RFLAcademy/SkateGuard/Documentation/Phase 1 - Foundation & Design/README.md

# Phase 1 — Foundation and Design (Week 1)

**Planned:** finalise the prototype layout, lock the wobble threshold, confirm the kickflip approach and procure the hardware.

**Delivered:** the layout and the detection approach were fixed, and the parts list was bought around two XIAO ESP32-C3 boards.

- Board unit mounted under the deck on a plate that bolts around the truck baseplate; wrist unit on a strap.
- Parts: two Seeed XIAO ESP32-C3 boards, a BNO055 IMU, a NEO-8M GPS, an SSD1306 128×32 OLED, two 1500 mAh lithium cells, two USB-C charging modules, a vibration motor and indicator LEDs.
- Kickflip detection scoped to rotation on one gyro axis, with the landing judged by how the deck settles rather than by an impact spike.
- Wobble redefined as a counted oscillation pattern instead of a 25 km/h speed trigger. The reasoning is in the root [README](../../README.md) and the project report.

## CAD design

Both enclosures were designed in CAD before anything was printed, so component clearances, port positions and the mounting pattern were settled on screen rather than in filament. Both are 3D-printed, two-part enclosures holding their board, a 1500 mAh lithium cell and a USB-C charging module, with every port and indicator reachable without opening the case.

### Board unit

The board enclosure is a mounting plate that sits between the deck and the truck, with the hardware split into three compartments so each part gets what it needs: the GPS patch antenna faces up with a clear view of the sky, the IMU sits in its own pod on the plate's edge where it reads the deck's rotation directly, and the XIAO, cell and charging module fill the opposite compartment. The oval and slotted cut-outs drop weight and clear the mounting bolts.

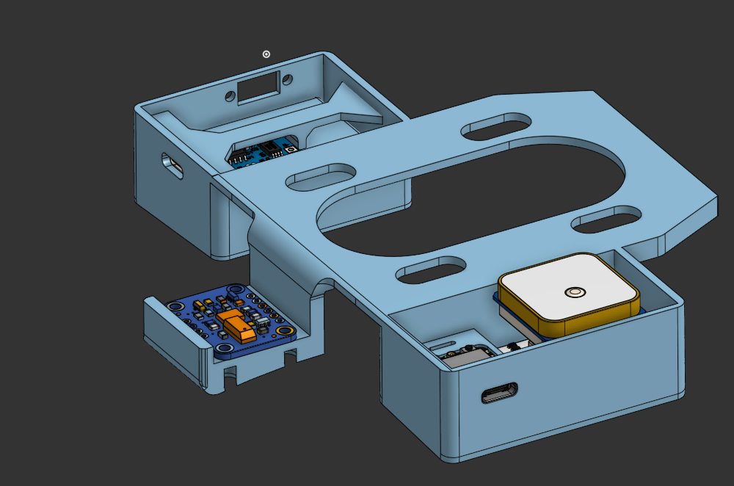
[picture p10: Documentation/Phase 1 - Foundation & Design/images/board_exploded.png]
Board enclosure, base and lid separated, showing the IMU pod and the GPS antenna


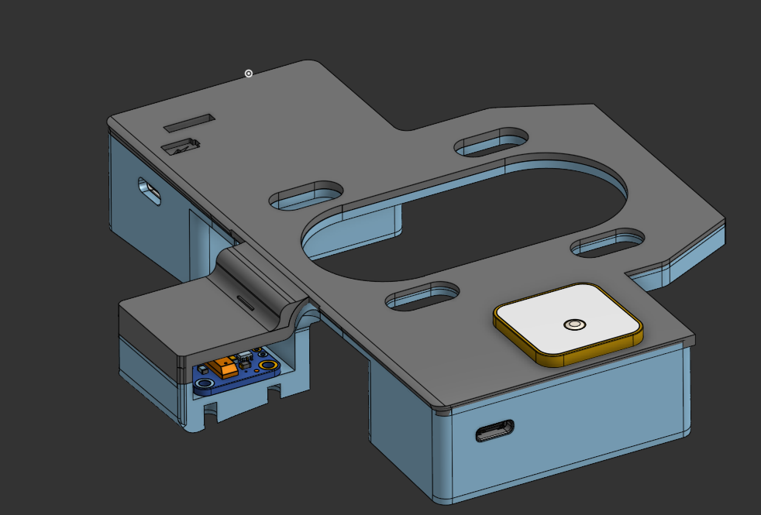
[picture p11: Documentation/Phase 1 - Foundation & Design/images/board_assembled.png]
Board enclosure assembled on its mounting plate


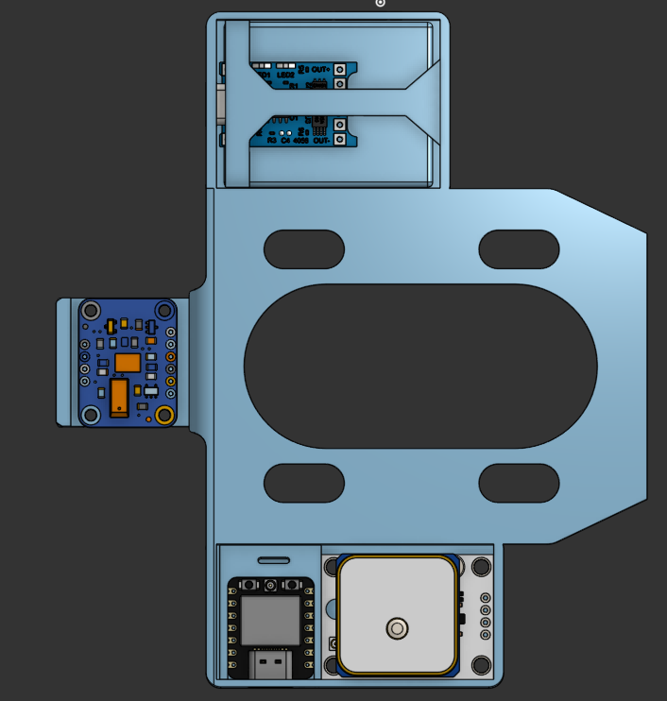
[picture p12: Documentation/Phase 1 - Foundation & Design/images/board_layout_plan.png]
Plan view with the IMU pod, the XIAO, the GPS antenna and the charging modules in place


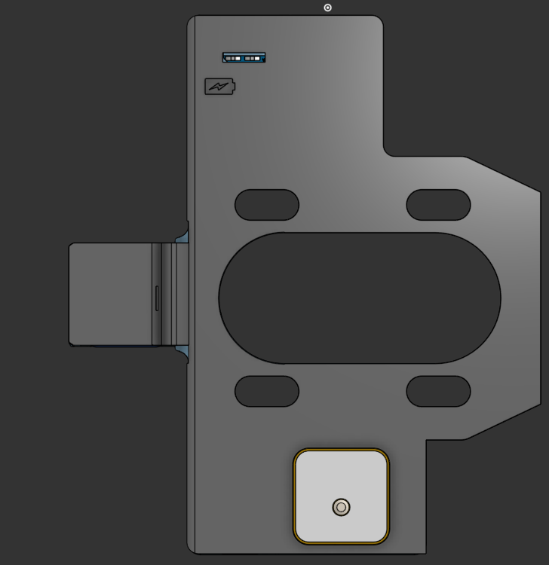
[picture p13: Documentation/Phase 1 - Foundation & Design/images/board_closed_plan.png]
Closed plan view with the status window and charge indicator


### Wrist unit

The wrist enclosure is a lidded box with lugs at all four corners for the strap. The OLED sits in a window in the lid with its four pins (GND, VCC, SCL, SDA) running to the XIAO below, and the two indicator LEDs show through beneath it. The USB-C port of the charging module is recessed into the side wall, so the unit charges on the wrist without being opened.

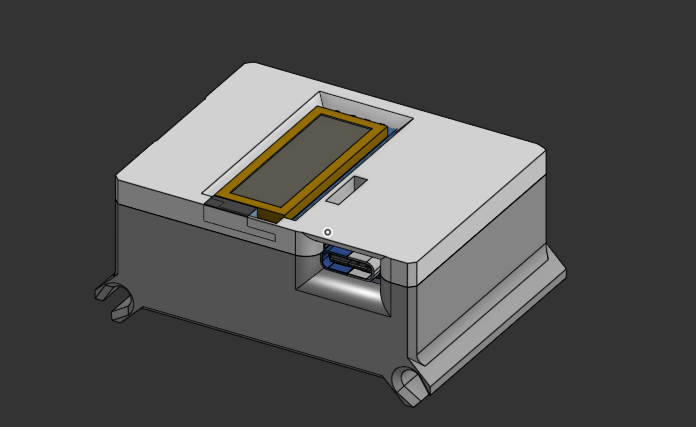
[picture p14: Documentation/Phase 1 - Foundation & Design/images/wrist_assembled.png]
Wrist unit assembled, OLED window in the lid and strap lugs at the corners


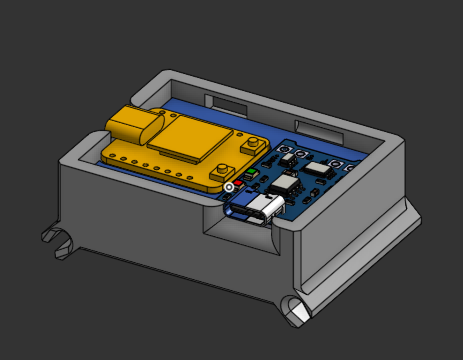
[picture p15: Documentation/Phase 1 - Foundation & Design/images/wrist_interior_iso.png]
Wrist unit with the lid off, XIAO stacked over the charging module


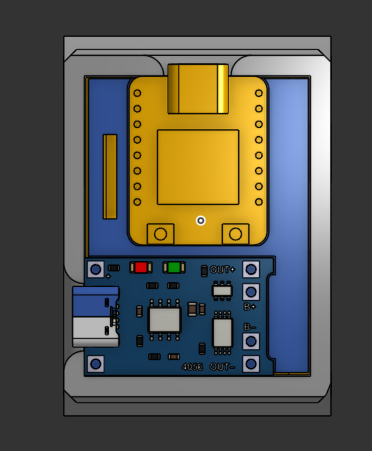
[picture p16: Documentation/Phase 1 - Foundation & Design/images/wrist_interior_plan.png]
Interior plan view: XIAO, charging module, indicator LEDs and side button


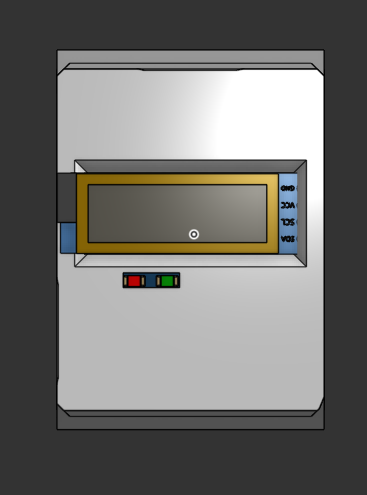
[picture p17: Documentation/Phase 1 - Foundation & Design/images/wrist_front.png]
Front view with the OLED window, its pin labels and the two indicator LEDs


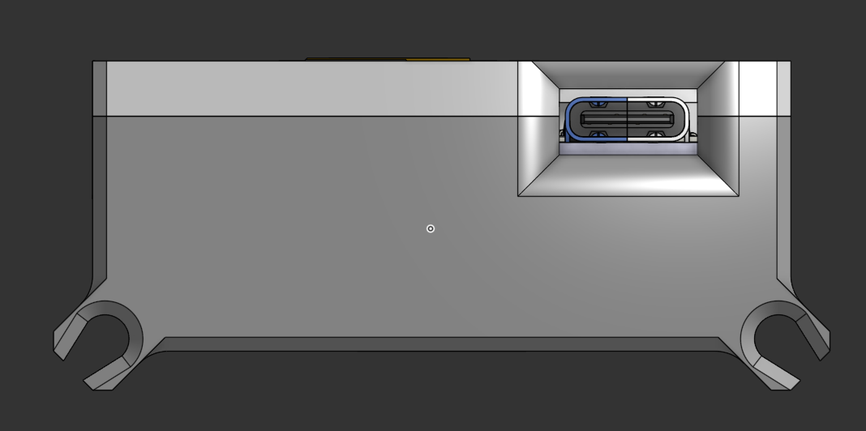
[picture p18: Documentation/Phase 1 - Foundation & Design/images/wrist_side_usb.png]
Side view with the recessed USB-C charging port


## Open question

Print material, layer height, infill and the finished dimensions of each enclosure are not recorded yet.
