RFLAcademy/SkateGuard/Documentation/Phase 5 - Companion Dashboard & Data Logging/sessions-and-downloads.md

# Phase 5 — Sessions & Downloads

Keeping rides on the board, drawing them on a map, and getting them off the board again.

## How it works

A session is started and stopped from the dashboard. Stopping does not save: the card offers **Save** or **Discard**, and nothing is written until one is chosen. Saving appends the ride's average speed, distance, land count and bail count, and stores its route as a separate line.

Storage is LittleFS on the board's own flash partition, which is separate from program space, so a nearly full sketch cannot squeeze the data out.

| File | Contents | Limit |
|---|---|---|
| `sessions.csv` | One line per saved session | Last 7 sessions |
| `routes.csv` | One line per session, `latitude:longitude` pairs | 20 points per session |
| `stage_log.csv` | Motion log for tuning | 2000 rows, cleared at boot |

Line N of `routes.csv` belongs to session N. A session recorded without GPS writes a `-` placeholder rather than a blank line, and the trimming helpers no longer skip blank lines. An earlier version skipped them, which slid every later route onto the wrong session as soon as one no-GPS session was saved — the map for a park lap would appear under a kickflip practice session.

## Downloads

Each row in Recorded Sessions has a download arrow. It produces:

- a **CSV** of that session: index, uptime when saved, average speed, distance, land and bail counts, point count and the route points; and
- a **PNG map** of the route, for sessions that have one.

The map is rendered in the browser on a canvas: the route's bounding box picks a zoom, OpenStreetMap tiles are fetched with CORS enabled and drawn, the route is stroked as a dashed orange line with red points, and a stats strip is drawn underneath. If tiles cannot be read back from the canvas, the route still renders on a plain background with a note. Sessions with no route get the CSV only, which is the normal case for practising one trick in one spot.

## Testing

The dashboard page was exercised in a browser against a simulated board: the save and discard paths, the 7-session cap dropping the oldest, deleting individual sessions, and downloads for sessions with and without a route. The route alignment fix was checked against the exact case that broke it — a no-GPS session saved between two GPS sessions, then a delete.

## Open issues

- Deleting a session happens immediately, with no confirmation.
- Only the last 7 sessions are kept; an eighth save drops the oldest.
- Sessions survive power-off but are erased if the board is reflashed with a different partition scheme.
- Route points every 30 seconds mean the drawn line cuts corners.
