RFLAcademy/SkateGuard/Documentation/Final Report/SkateGuard-Manual.html

# SkateGuard Dashboard Manual

26 September 2026

## Before you start

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

You need four things:

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

The wearable screen reading Dashboard: 192.168.43.200 with a countdown in the corner

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

Screenshots here come from a preview fed with sample ride data, so your numbers will differ.

## Opening the dashboard

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

SkateGuard start screen with the Open Dashboard button

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

## The dashboard screen

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

Dashboard showing Speed, GPS, Wobble, Trick Status, the Land and Bail bar and the session card

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

## Recording a session

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

Dashboard while recording, showing 0.16 km and Land 6, Bail 1

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

The same card after Stop, showing the Save and Discard buttons

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

## The live map

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

Live map with the overlay reading Speed 12.9 km/h, Distance 0.04 km, Avg speed 5.0 km/h, Land 2 Bail 1

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

The live map during a real ride, reading Speed 11.7 km/h, Distance 2.40 km, Avg speed 14.9 km/h, Land 0 Bail 0

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

## Recorded sessions

The clipboard icon on the session card opens everything the board has saved.

Recorded Sessions list with three sessions, each with a download and a delete button

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

Each row has three things you can tap:

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

Downloaded route map of a 2.44 km session, with distance, average speed, land and bail counts along the bottom

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

## A saved session's route

Tapping a row draws where that ride went, with the session's numbers underneath.

Session 1 route on a map, with Distance 0.87 km, Avg Speed 11.8 km/h, Land 7 and Bail 2 below it

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

Tap the cross at the top right to go back to the list.

## The debug page

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

Debug page listing stage, motion windows, counts, GPS and radio values

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

## If something goes wrong

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

## What the board keeps

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
