RFLAcademy/SkateGuard/(commit log)

2026-09-28 SkateGuard: board and wearable firmware, dashboard, documentation and manual
    Board firmware with BNO055 trick detection, NEO-8M GPS, a self-hosted web
    dashboard, an ESP-NOW link and on-board session storage; wearable receiver
    firmware; the dashboard page source; the session and route file formats;
    per-phase build documentation; and the user manual as PDF, Word and a web
    page.
    [routes.csv, sessions.csv]
2026-10-02 Record top speed and wobble alerts per session
    sessions.csv gains top_speed_kmh and wobble_count, appended after the
    existing columns so files written by older firmware still parse. Both
    values appear in the session list, the route dialog, the live map overlay
    and the per-session CSV download.
    Also makes the pins checkable rather than assumed: imuInit scans the I2C
    bus at boot, batteryInit logs a raw ADC count, and stage_log.csv now
    records gyro_x and gyro_z beside gyro_y so one real kickflip settles which
    axis WOBBLE_AXIS and KICKFLIP_AXIS should name.
    Compiles for XIAO_ESP32C3 at 91% program storage, 12% RAM.
    [sessions.csv]
2026-10-02 Reorganise documentation into six phases, one per project week
    Each phase folder now opens with that week's plan and what was delivered:
    Phase 1 foundation and design (with the CAD renders), Phase 2 hardware and
    enclosure (built units, wiring, pin table), Phase 3 sensor and embedded
    system, Phase 4 wireless alerts and bail detection, Phase 5 companion
    dashboard and data logging, Phase 6 testing and what is still open. The
    earlier deep-dives move into the phase that produced them.
    Adds the six-week project report as PDF and Word under Final Report.
2026-10-02 Convert the assembly photos to JPEG so exports carry them
    The four build photos were WebP, which the PDF and Word export dropped
    silently: the first export held 14 images where the report has 18. They
    are now JPEG at full resolution, and Phase 2 points at the new files.
    Re-exports the six-week report: 22 pages, 18 images.
2026-10-09 Trim comments that describe superseded builds
    Both sketches carried long comparisons with the Firebase sender, the BLE
    build and the older wearable receiver — sketches that are no longer part
    of this project, so the comparisons explained nothing about the code they
    sat above. Those are rewritten to state what the code does, the
    decorative rule lines are gone, and both headers are about half their
    former length.
    Every comment that records a debugging lesson stays: the routes.csv blank
    line rule, Serial printing out of the ESP-NOW callback, retuning to the
    channel the board states, the gyro clamp figures, the GPS jump filter and
    fix-age checks, modem sleep, and the DHCP-then-pin fallbacks.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
2026-10-09 Cut every comment down to three lines or fewer
    42 blocks in the sender and 5 in the receiver ran to four lines and more,
    several past ten. Each is now one to three lines stating the fact once:
    the routes.csv blank-line rule, the elapsed-time jump filter, the gyro
    clamp figures, modem sleep, the DHCP-then-pin fallback, the land/bail
    latch fix. Nothing that records a debugging lesson was dropped.
    Sender 3272 -> 3047 lines, receiver 504 -> 489. Both still compile
    (sender 91% flash, receiver 74%); the sender's binary is 3 KB smaller
    because the trimmed dashboard comments ship inside the served page.
